xmartinalarx/SortiBandLLM/hardware/3d/manzanas/blender/vista_desviador.png

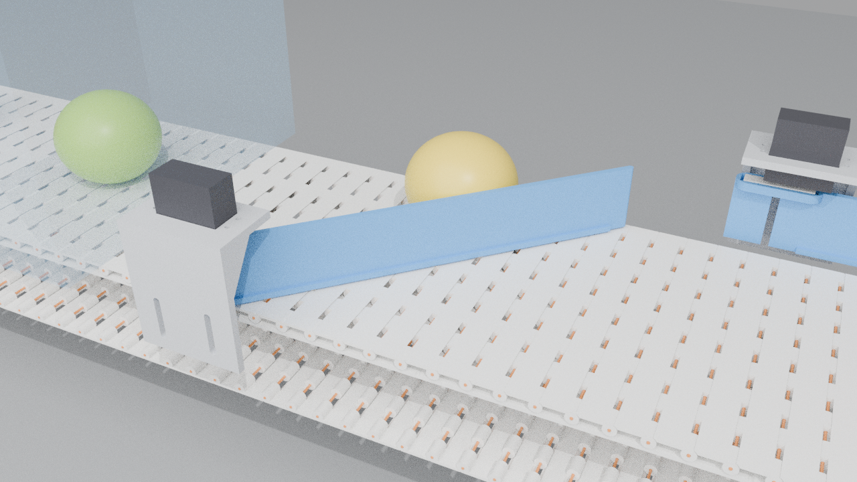
hardware/3d/manzanas/blender/vista_desviador.png
