xmartinalarx/SortiBandLLM/hardware/3d/manzanas/impresion/REPARTO.md

# Reparto de impresión entre los 4 integrantes

> **En la Ender-3 V3 KE del laboratorio** no usen estos STL directamente: impriman los G-code de `../gcode_Ender3V3KE_0.4_v2/` (terminan en `_v2`) y, para los eslabones, el de agujero de 2,1 mm (`01_eslabones_agujero_d21_v2.gcode`). En la KE cada integrante tarda unas 28–30 h.

Todo el proyecto se reparte en 4 paquetes parejos. Cada uno imprime 4 placas de eslabones (28 eslabones) más un subsistema.

| Integrante | Subsistema | Impresiones | Tiempo | Filamento |
|---|---|---|---|---|
| Persona 1 | banda y paletas desviadoras | 7 | 40 h 35 min | ~556 g |
| Persona 2 | banda, soportes de servo y cama | 8 | 39 h 46 min | ~534 g |
| Persona 3 | banda, piñones del eje tensor y cama | 7 | 38 h 11 min | ~493 g |
| Persona 4 | banda, piñones del eje motriz y cama | 7 | 38 h 11 min | ~493 g |
| **Total** | | | **156 h 44 min** | **~2.08 kg** |

Además, los pasadores usan unos 22 m de filamento (~70 g), que cada uno saca de su propio rollo.

Con una impresora por persona y 2 impresiones al día, todo queda listo en 3 días, con 1 día de margen. Cada integrante necesita medio rollo de 1 kg de PETG blanco.

Reglas comunes:
- Todos usan el mismo perfil (`perfil_PETG_PrusaSlicer.ini`) y PETG blanco, para que los eslabones salgan iguales.
- Cada uno imprime su propia prueba de tolerancia antes de los eslabones.
- Cada uno arma su tramo de 28 eslabones; al final se unen los 4 tramos.
