xmartinalarx/SortiBandLLM/hardware/3d/manzanas/blender/vista_general.png

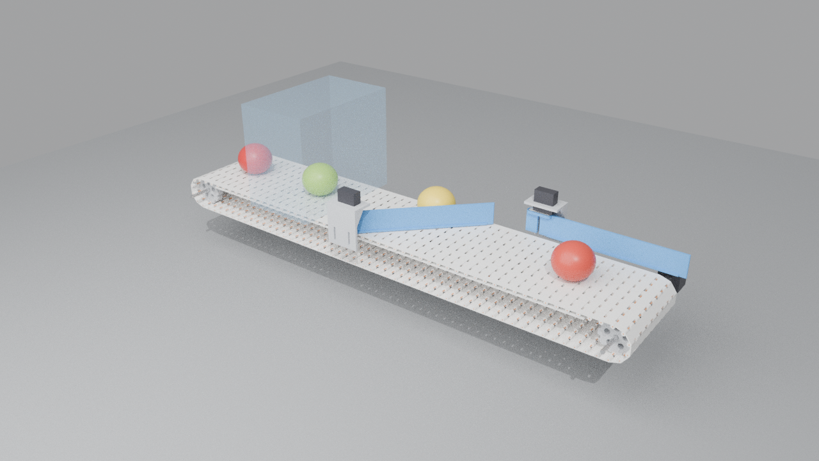
hardware/3d/manzanas/blender/vista_general.png
