xmartinalarx/SortiBandLLM/img-Ref/WhatsApp Image 2026-11-05 at 11.46.27 AM.jpeg

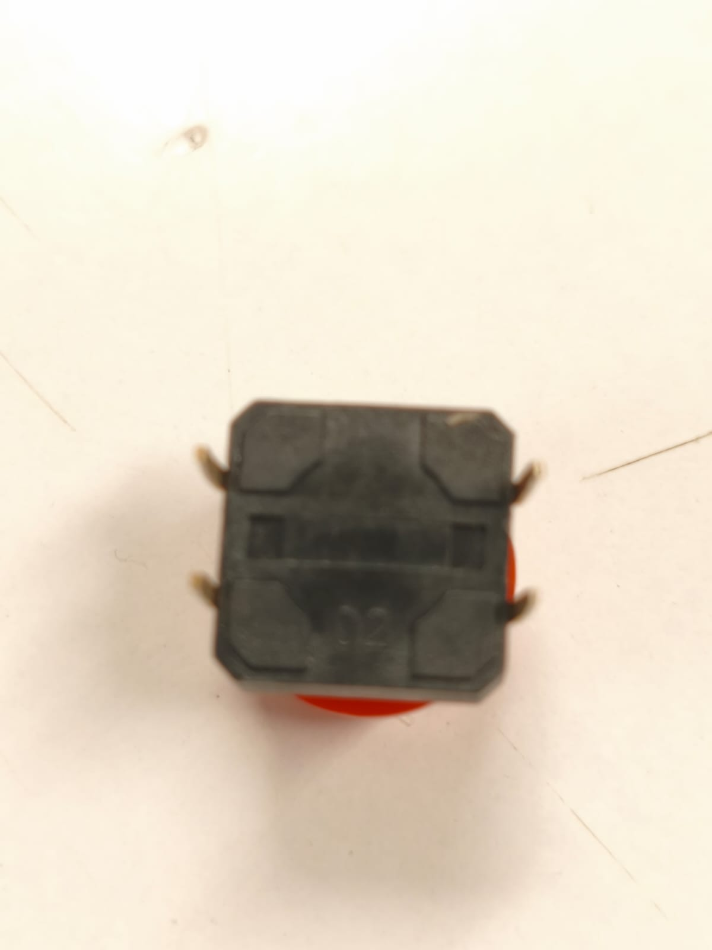
img-Ref/WhatsApp Image 2026-11-05 at 11.46.27 AM.jpeg
