xmartinalarx/SortiBandLLM/img-Ref/WhatsApp Image 2026-11-05 at 11.49.01 AM.jpeg

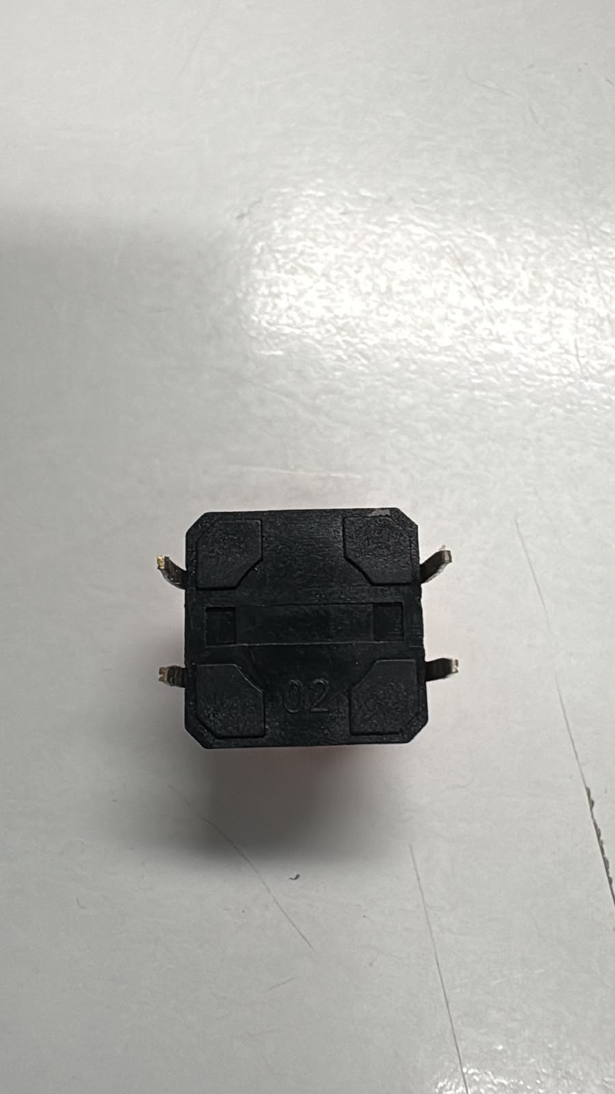
img-Ref/WhatsApp Image 2026-11-05 at 11.49.01 AM.jpeg
