xmartinalarx/SortiBandLLM/hardware/3d/manzanas/impresion/persona_1/01_eslabones_7_x4.stl

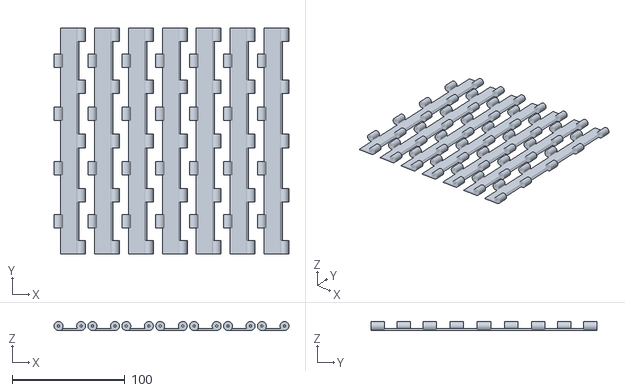
[picture p12: CAD file, 2026-11-12]
hardware/3d/manzanas/impresion/persona_1/01_eslabones_7_x4.stl
208.0 x 200.0 x 8.00
