xmartinalarx/SortiBandLLM/hardware/3d/manzanas/impresion/persona_3/03_cama_x1.stl

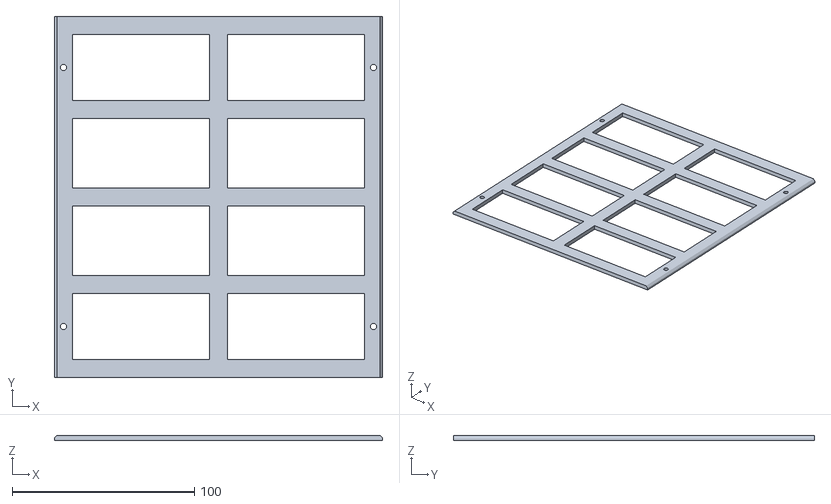
[picture p13: CAD file, 2026-11-12]
hardware/3d/manzanas/impresion/persona_3/03_cama_x1.stl
180.0 x 198.0 x 3.00
