xmartinalarx/SortiBandLLM/hardware/3d/manzanas/stl/piezas/paleta_parte_A.stl

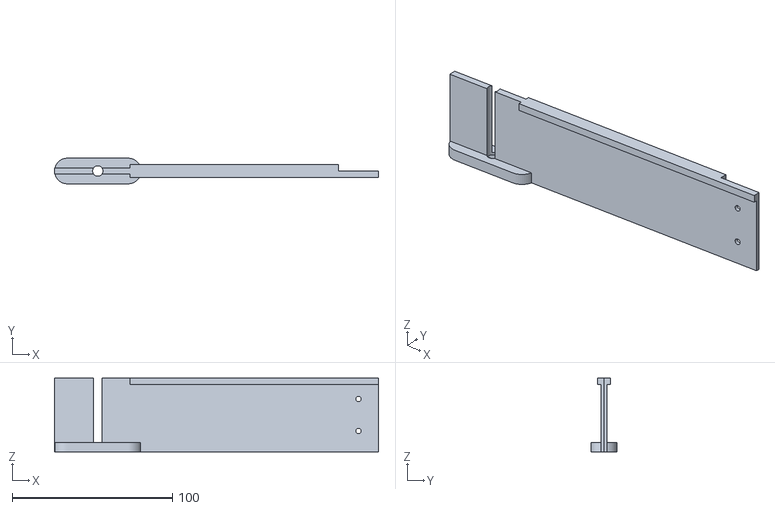
[picture p14: CAD file, 2026-11-12]
hardware/3d/manzanas/stl/piezas/paleta_parte_A.stl
202.0 x 16.0 x 46.0
