xmartinalarx/SortiBandLLM/hardware/3d/manzanas/stl/placas/05_pinones_3.stl

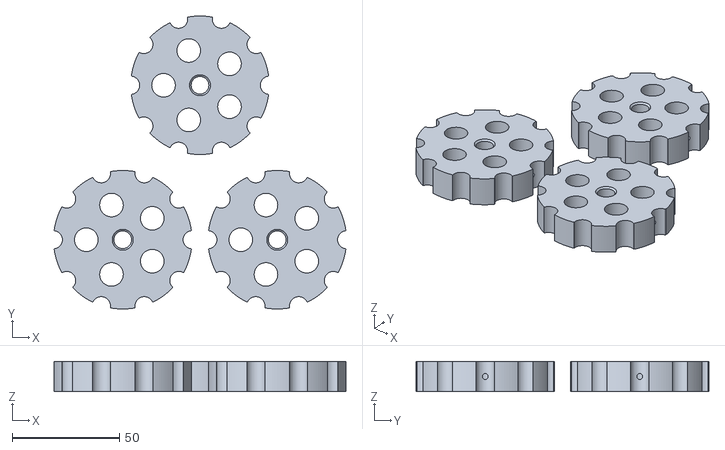
[picture p15: CAD file, 2026-11-12]
hardware/3d/manzanas/stl/placas/05_pinones_3.stl
136.0 x 136.6 x 14.0
