xmartinalarx/SortiBandLLM/hardware/3d/manzanas/impresion/persona_3/00_prueba_tolerancia.stl

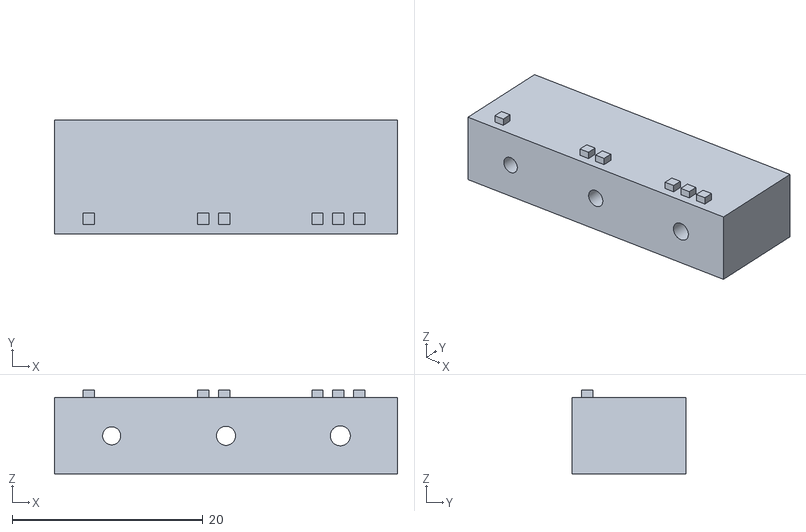
[picture p16: CAD file, 2026-11-12]
hardware/3d/manzanas/impresion/persona_3/00_prueba_tolerancia.stl
36.0 x 12.0 x 8.80
