xmartinalarx/SortiBandLLM/hardware/3d/manzanas/impresion/persona_1/02_paletas_2A_2B_x1.stl

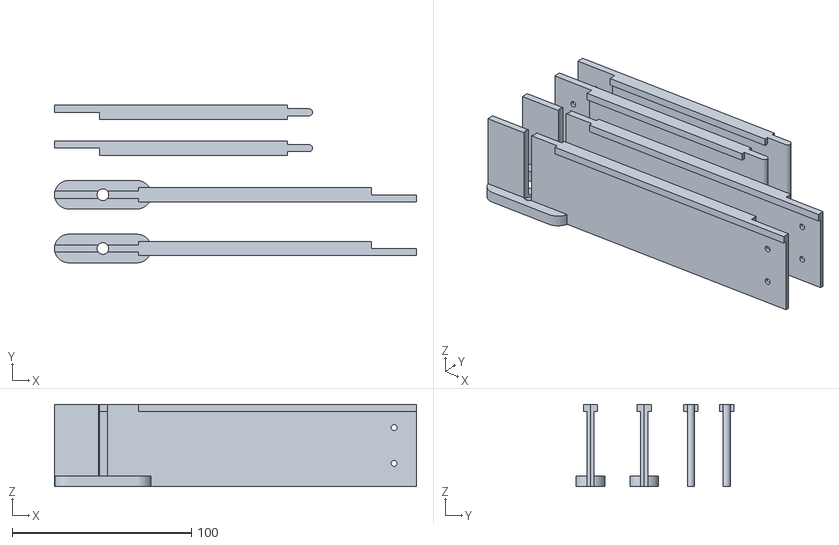
[picture p17: CAD file, 2026-11-12]
hardware/3d/manzanas/impresion/persona_1/02_paletas_2A_2B_x1.stl
202.0 x 88.0 x 46.0
