xmartinalarx/SortiBandLLM/hardware/3d/manzanas/impresion/persona_2/02_soportes_servo_x1.stl

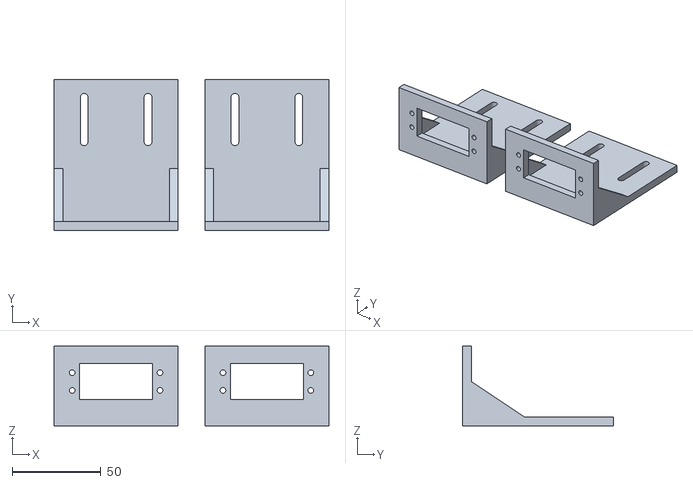
[picture p18: CAD file, 2026-11-12]
hardware/3d/manzanas/impresion/persona_2/02_soportes_servo_x1.stl
155.0 x 85.0 x 45.0
