xmartinalarx/SortiBandLLM/hardware/3d/manzanas/stl/piezas/soporte_servo_MG996R.stl

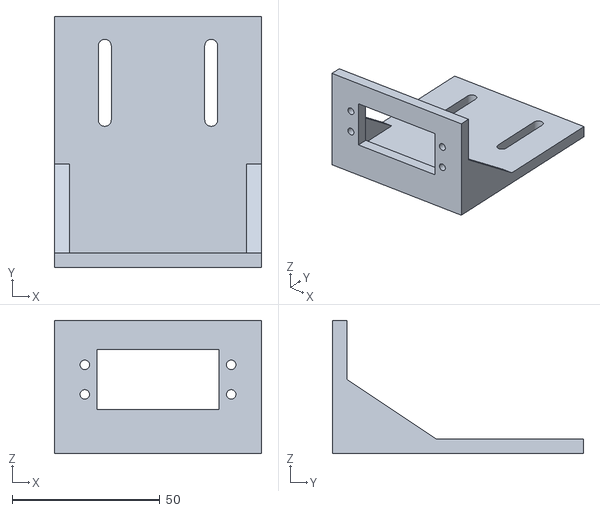
[picture p19: CAD file, 2026-11-12]
hardware/3d/manzanas/stl/piezas/soporte_servo_MG996R.stl
70.0 x 85.0 x 45.0
