xmartinalarx/SortiBandLLM/hardware/3d/manzanas/stl/piezas/eslabon_agujero_1.9.stl

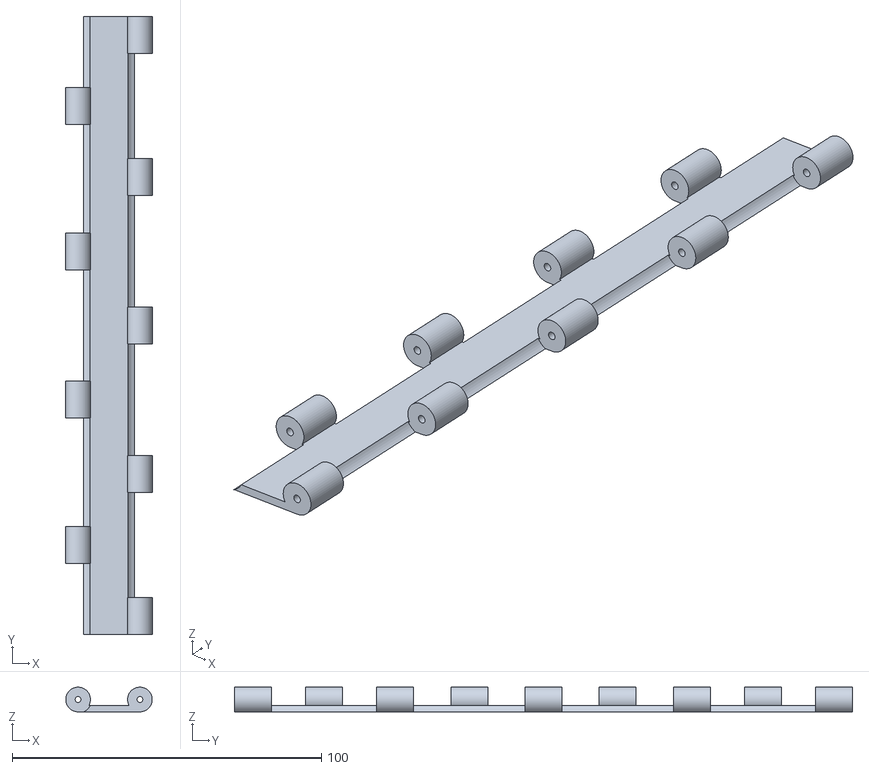
[picture p20: CAD file, 2026-11-12]
hardware/3d/manzanas/stl/piezas/eslabon_agujero_1.9.stl
28.0 x 200.0 x 8.00
