xmartinalarx/SortiBandLLM/hardware/3d/manzanas/stl/piezas/paleta_parte_B.stl

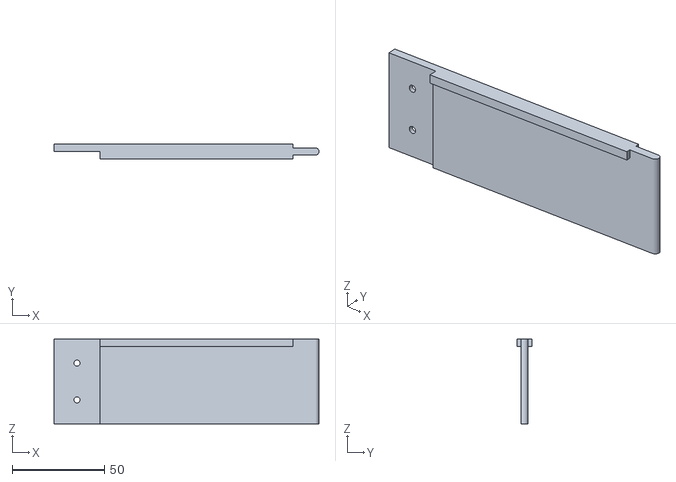
[picture p21: CAD file, 2026-11-12]
hardware/3d/manzanas/stl/piezas/paleta_parte_B.stl
144.0 x 8.00 x 46.0
