xmartinalarx/SortiBandLLM/hardware/3d/manzanas/stl/piezas/pinon.stl

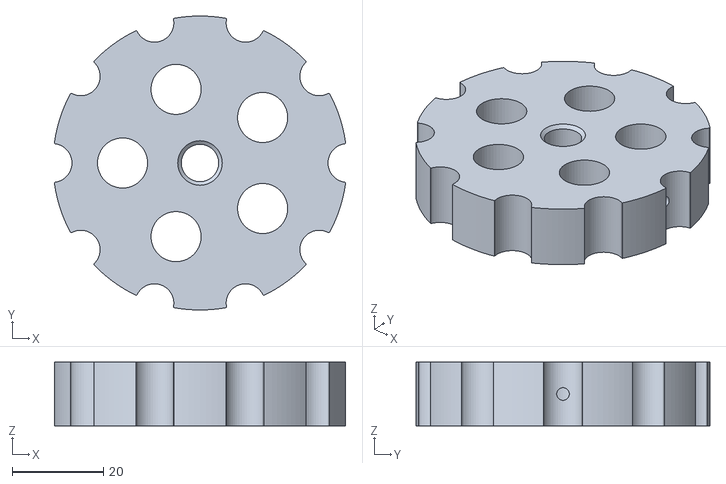
[picture p22: CAD file, 2026-11-12]
hardware/3d/manzanas/stl/piezas/pinon.stl
64.0 x 64.6 x 14.0
