xmartinalarx/SortiBandLLM/hardware/3d/manzanas/stl/piezas/paleta_completa_referencia.stl

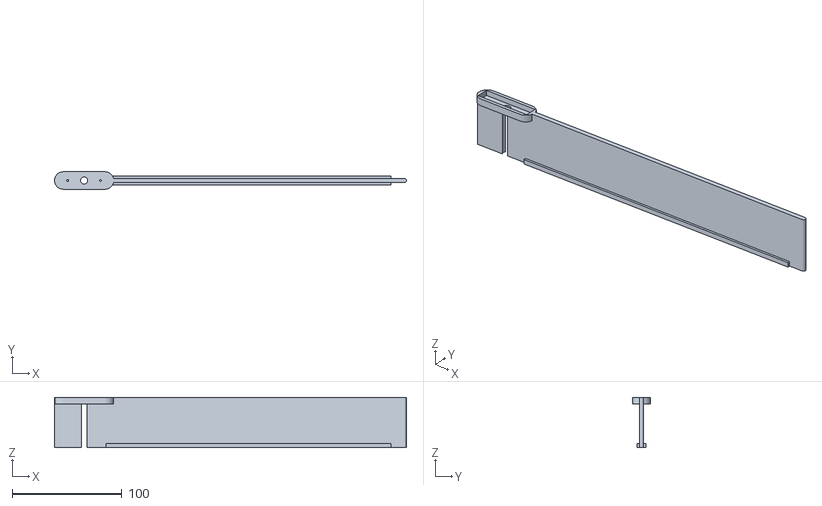
[picture p23: CAD file, 2026-11-12]
hardware/3d/manzanas/stl/piezas/paleta_completa_referencia.stl
321.0 x 16.0 x 46.0
