xmartinalarx/SortiBandLLM/(list of files, cad)

Other CAD files:
hardware/3d/manzanas/impresion/persona_1/variantes/eslabones_7_agujero_2.1_x4.stl
hardware/3d/manzanas/impresion/persona_2/variantes/eslabones_7_agujero_1.9_x4.stl
hardware/3d/manzanas/impresion/persona_3/variantes/eslabones_7_agujero_2.1_x4.stl
hardware/3d/manzanas/impresion/persona_4/variantes/eslabones_7_agujero_2.1_x4.stl
hardware/3d/manzanas/impresion/persona_1/variantes/eslabones_7_agujero_1.9_x4.stl
hardware/3d/manzanas/impresion/persona_2/variantes/eslabones_7_agujero_2.1_x4.stl
hardware/3d/manzanas/impresion/persona_3/variantes/eslabones_7_agujero_1.9_x4.stl
hardware/3d/manzanas/impresion/persona_4/02_pinones_x1.stl
hardware/3d/manzanas/impresion/persona_4/variantes/eslabones_7_agujero_1.9_x4.stl
hardware/3d/manzanas/stl/piezas/prueba_tolerancia.stl
hardware/3d/manzanas/impresion/persona_3/02_pinones_x1.stl
hardware/3d/manzanas/stl/placas/00_prueba_tolerancia.stl
hardware/3d/manzanas/stl/piezas/cama_tramo.stl
hardware/3d/manzanas/stl/piezas/eslabon_agujero_2.0.stl
hardware/3d/manzanas/stl/placas/01_eslabones_7_agujero_1.9.stl
hardware/3d/manzanas/stl/piezas/eslabon_agujero_2.1.stl
hardware/3d/manzanas/stl/placas/01_eslabones_7_agujero_2.1.stl
hardware/3d/manzanas/blender/clasificador_manzanas.blend
