xmartinalarx/SortiBandLLM/hardware/3d/manzanas/imagenes/armado_eslabones.png

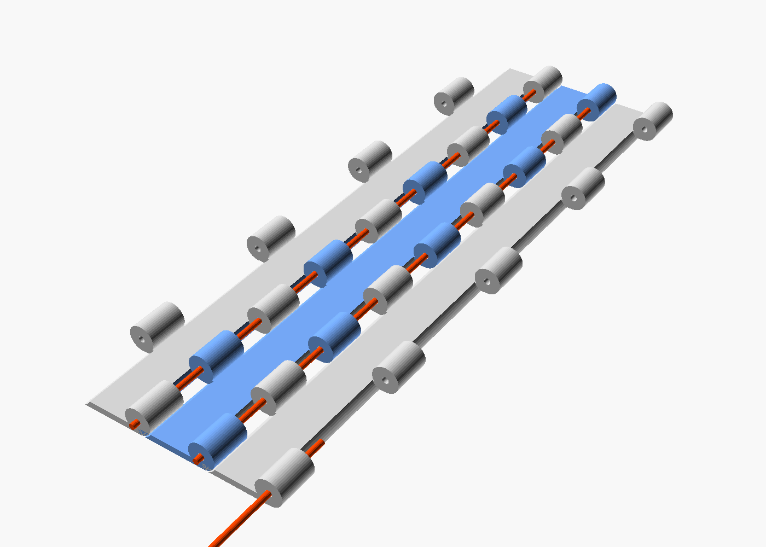
hardware/3d/manzanas/imagenes/armado_eslabones.png
