xmartinalarx/SortiBandLLM/(commit log)

2026-11-12 Primera versión de SortiBandLLM (pythonGroup)
    Clasificador IoT de manzanas sobre banda transportadora: firmware del
    Arduino UNO R4 WiFi, visión con CLIP y respaldo OpenCV, servidor FastAPI
    con puente MQTT a MySQL, dashboard web, simulador, pruebas e informes.
2026-11-12 Agregar archivos 3D, datos de impresión y nombre SortiBandLLM
    - hardware/3d: modelo OpenSCAD, STL, G-code v2 para la Ender-3 V3 KE,
    escena de Blender, renders, reparto por integrante y versión M&M histórica.
    - CLAUDE.md: impresora real, perfil, agujero de 2,1 mm, pasadores PLA+,
    ~115 h de impresión y avance (4 placas de eslabones impresas).
    - LEEME de la mecánica alineado con el motor 28BYJ-48 y 30 mm/s.
    - README e informes con el nombre SortiBandLLM (grupo pythonGroup).
    [00_prueba_tolerancia.stl, 01_eslabones_7_agujero_1.9.stl, 01_eslabones_7_agujero_2.0.stl, 01_eslabones_7_agujero_2.1.stl, 01_eslabones_7_x4.stl, 02_paletas_2A_2B_x1.stl, 02_paletas_A_B.stl, 02_pinones_x1.stl]
2026-11-12 Quitar la versión histórica de M&M de hardware/3d
    [1_prueba_tolerancia.stl, 2_eslabon_agujero_2.0.stl, 3_placa_40_eslabones_agujero_2.0.stl, 4_pinon_imprimir_2.stl, 5_cama_deslizamiento_imprimir_3.stl, banda_ensamblada.blend, banda_eslabones.scad, eslabon_agujero_1.9.stl]
2026-11-12 Anotar lo que falta imprimir y el plan con 2 impresoras
2026-11-12 Separar el proyecto en dos carpetas: servidor/ e ia/
    Cada carpeta se copia a su PC y se levanta sola, con su .env,
    requirements.txt y LEEME.md.
    - servidor/: broker, API, puente MQTT -> MySQL, dashboard, simulador,
    verificar_flujo e instalador.
    - ia/: visión (CLIP + OpenCV), comparar_motores y pruebas.
    - comun/topicos.py queda duplicado en los dos lados; la lista COLORES
    pasa ahí, así el servidor ya no importa nada de la visión.
    - El PC-IA ya no lee MySQL: pide la configuración y sube las fotos por
    HTTP al servidor.
    - README, CLAUDE.md y guías de conexión actualizados con las rutas nuevas.
2026-11-12 Levantar y apagar el PC-servidor con doble clic (INICIAR_SERVIDOR.bat y DETENER_SERVIDOR.bat)
2026-11-12 Documentar el inicio con doble clic y cómo reparar MySQL si se daña
2026-11-12 Levantar el PC-IA con doble clic (INICIAR_IA.bat e INICIAR_IA_SIN_CAMARA.bat)
2026-11-12 Red TARRO con IP fija del servidor y prueba de conexión sin falsos positivos en los .bat
